jnedbal/MicroFLiC_DAC_2_2/MicroFLiC_DAC.csv

Reference | Quantity | Value | Footprint | Datasheet | Part Number | Manufacturer | Package | Supplier | Order Code | Alt. Supplier | Alt. Order Code | Note
C12 C30 C36 C38 C44 C45 C46 C49 C50 C61 C62 C73 C78 | 13 | 22u/25V | Capacitors_SMD:C_1210 |  | GRM32ER61E226ME15L | Murata | 1210 | Farnell | 1735539 | Mouser | 81-GRM32ER61E226ME5L | 22μF/25V X5R 1210 ceramic capacitor
C14 C22 C33 C41 | 4 | 10p | Capacitors_SMD:C_0603 |  | CC0603JRNPO9BN100 | Yageo | 0603 | Farnell | 721967 | Mouser | 603-C0603JRNPO9BN100 | 10pF/50V C0G(NP0) 0603 ceramic capacitor
C15 C20 C23 C28 C60 C72 | 6 | 10u/35V | Capacitors_SMD:C_1210 |  | GRM32ER6YA106KA12L | Murata | 1210 | Farnell | 1845763 | Mouser | 81-GRM32ER6YA106KA2L | 10μF/35V X5R 1210 ceramic capacitor
C10 C11 C16 C19 C2 C24 C27 C31 C35 C39 C4 C43 C63 C68 C75 C76 C77 C8 | 18 | 100n | Capacitors_SMD:C_0603 |  | CC0603KRX7R9BB104 | Yageo | 0603 | Farnell | 1362556 | Mouser | 603-CC603KRX7R9BB104 | 100nF/50V X7R 0603 ceramic capacitor
C47 C48 C69 | 3 | 1u/25V | Capacitors_SMD:C_0603 |  | GCM188R71E105KA64D | Murata | 0603 | Farnell | 2470425 | Mouser | 603-CC603KRX7R8BB105 | 1μF/25V X7R 0603 ceramic capacitor
C13 C17 C18 C21 C25 C26 C29 C32 C34 C37 C40 C42 C5 C54 C55 C56 C57 C58 C59 C6 C66 C67 C70 C71 | 24 | 10n | Capacitors_SMD:C_0603 |  | CC0603KRX7R9BB103 | Yageo | 0603 | Farnell | 722236 | Mouser | 603-CC603KRX7R9BB103 | 10nF/50V X7R 0603 ceramic capacitor
C51 C52 C53 C64 C65 C74 | 6 | 10u/25V | Capacitors_SMD:C_0805 |  | GRM219R61E106KA12D | Murata | 0805 | Farnell | 2426961 | Mouser | 603-CC805KKX5R8BB106 | 10μF/25V X5R 0805 ceramic capacitor
C1 C3 C7 C9 | 4 | 4u7/25V | Capacitors_Tantalum_SMD:TantalC_SizeB_EIA-3528_Reflow |  | TR3B475K025C0700 | Vishay | case B | Farnell | 2353145 | Mouser | 74-TR3B475K025C0700 | 4.7μF/25V/0.7Ω ESR case B tantalum capacitor
JP1 | 1 | UNI_A | jakub:solder_jumper
JP2 | 1 | UNI_B | jakub:solder_jumper
JP3 | 1 | x2_0 | jakub:solder_jumper
JP4 | 1 | x2_1 | jakub:solder_jumper
JP5 | 1 | x2_2 | jakub:solder_jumper
JP6 | 1 | x2_3 | jakub:solder_jumper
JP7 | 1 | GND/GNDA | jakub:solder_jumper
P1 | 1 | 8-way Micro-MaTch | jakub:7-188275-8 |  | 7-188275-8 | TE Connectivity | Micro-MaTch SMD | Farnell | 3784733 | Mouser | 571-7-188275-8 | 8-way SMD Micro-MaTch connector
P2 | 1 | 2x4 header strip | Pin_Headers:Pin_Header_Straight_2x04 |  | M20-9980446 | Harwin | DIL-8 | Farnell | 1022233 | Mouser | 855-M20-9980446 | 2x4 header strip
P3 | 1 | 1x2 header strip | Pin_Headers:Pin_Header_Straight_1x02 |  | M20-9990245 | Harwin | SIL-2 | Farnell | 1022245 | Mouser | 855-M20-9990245 | 1x2 header strip
P4 | 1 | 1x2 socket strip | Socket_Strips:Socket_Strip_Straight_1x02 |  | ESQ-102-33-G-S | Samtec | SIL-2 | Farnell | 1927389 | Samtec | ESQ-102-33-G-S | 1x2 ESQ series elevated socket strip
P5 P6 P7 P8 | 4 | SMA | jakub:SMA |  | 73251-2200 | Molex | SMA | Farnell | 2293854 | Mouser | 538-73251-2200 | Right-angle SMA jack
R1 R13 R15 R17 R19 R2 R21 R22 R23 R24 R3 | 11 | 12k | Resistors_SMD:R_0603 |  | RC0603FR-0712KL | Yageo | 0603 | Farnell | 9238611 | Mouser | 603-RC0603FR-0712KL | 10kΩ/1% 0805 resistor
R10 R11 | 2 | 1 | Resistors_SMD:R_0805 |  | MCWR08W1R00FTL | Multicomp | 0805 | Farnell | 2447598 | Mouser | 667-ERJ-6GEYJ1R0V | 1Ω/1% 0805 resistor
R12 R18 | 2 | 165k | Resistors_SMD:R_0805 |  | MCMR08X1653FTL | Multicomp | 0805 | Farnell | 2073657 | Mouser | 667-ERJ-6ENF1653V | 165kΩ/1% 0805 resistor
R14 R16 R20 | 3 | 48k7 | Resistors_SMD:R_0805 |  | MC01W0805148K7 | Multicomp | 0805 | Farnell | 2141883 | Mouser | 667-ERJ-6ENF4872V | 48.7kΩ/1% 0805 resistor
R25 | 1 | 150 | Resistors_SMD:R_0805 |  | MCWR08X1500FTL | Multicomp | 0805 | Farnell | 2447574 | Mouser | 71-TNPW0805150RFEEA | 150Ω/1% 0805 resistor
R4 R5 R6 R7 | 4 | 1k/0.01%/100mW | Resistors_SMD:R_0805 |  | MCTF0805TTX1001 | Multicomp | 0805 | Farnell | 2112790 | Mouser | 71-PLTT0805Z1001QGT5 | 1kΩ/0.01% 0805 resistor
R8 R9 | 2 | 49R9/0.1%/250mW | Resistors_SMD:R_0805 |  | RP73PF2A49R9BTDF | TE Connectivity | 0805 | Farnell | 2117023 | Mouser | 279-RP73PF2A49R9BTDF | 49.9Ω/0.1%/250mW 0805 resistor
RP1 | 1 | 4x150 | Resistors_SMD:R_Array_Convex_4x0603 |  | YC164-JR-07150RL | Yageo | 4×0603 | Farnell | 9234462 | Mouser | 603-YC164-JR-07150RL | 4×150Ω/5% 0603 resistor array
S1 S2 | 2 | shield_can | jakub:can-MS257-10 |  | MS257-10 | Masach | Can | RS Components | 826-6766 | Masach | MS257-10 | Two-piece EMI shielding can
U1 | 1 | DAC8734 | Housings_QFP:TQFP-48_7x7mm_Pitch0.5mm |  | DAC8734SPFB | Texas Instruments | TQFP-48 | Farnell | 2082437 | Mouser | 595-DAC8734SPFB | Quad 16-bit DAC
U11 | 1 | LM3480 | TO_SOT_Packages_SMD:SOT-23 |  | LM3480IM3-5.0 | Texas Instruments | SOT-23 | Farnell | 3160634 | Mouser | 926-LM3480IM3-50 | 100-mA SOT-23 quasi low-dropout linear voltage regulator
U12 U13 | 2 | TPS7A3001 | jakub:SSOP8_powerPAD |  | TPS7A3001DGNT | Texas Instruments | MSOP-8 | Farnell | 1855138 | Mouser | 595-TPS7A3001DGNT | Ultralow-noise negative linear regulator
U14 | 1 | LM3880 | Housings_SOT-23_SOT-143_TSOT-6:SOT-23-6 |  | LM3880MF-1AB | Texas Instruments | SOT-23-6 | Farnell | 1271399 | Mouser | 926-LM3880MF1ABNOPB | 3-output power sequencer
U15 | 1 | 74AHC1G14 | Housings_SOT-23_SOT-143_TSOT-6:SOT-23-5 |  | SN74AHC1G14DBVR | Texas Instruments | SOT-23-5 | Farnell | 1105919 | Mouser | 595-SN74AHC1G14DBVR | Single Schmitt trigger inverter
U16 | 1 | Si8651 | Housings_SOIC:SOIC-16_3.9x9.9mm_Pitch1.27mm |  | SI8651EC-B-IS1 | Silicon Labs | SOIC-16 | Farnell | 2423323 | Mouser | 634-SI8651EC-B-IS1 | Digital isolators 5 channel 3.75kV 8ns 4/1
U2 U3 | 2 | OPA211 | Housings_SSOP:MSOP-8_3x3mm_Pitch0.65mm |  | OPA211AIDGKT | Texas Instruments | MSOP-8 | Farnell | 2323341 | Mouser | 595-OPA211AIDGKT | 1.1-nV/√Hz noise low power precision operational amplifier
U4 U5 | 2 | AD8021 | Housings_SOIC:SOIC-8_3.9x4.9mm_Pitch1.27mm |  | AD8021ARZ | Analog Devices | SOIC-8 | Farnell | 9426000 | Mouser | 584-AD8021ARZ | Low noise high speed amplifier for 16-bit systems
U6 | 1 | REF5040 | Housings_SSOP:MSOP-8_3x3mm_Pitch0.65mm |  | REF5040AIDGKT | Texas Instruments | MSOP-8 | Farnell | 2323788 | Mouser | 595-REF5040AIDGKT | 5.000V low-noise very low drift precision voltage reference
U7 | 1 | REF5050 | Housings_SSOP:MSOP-8_3x3mm_Pitch0.65mm |  | REF5050AIDGKT | Texas Instruments | MSOP-8 | Farnell | 2323802 | Mouser | 595-REF5050AIDGKT | 4.096V low-noise very low drift precision voltage reference
U10 U8 U9 | 3 | TPS7A4901 | jakub:SSOP8_powerPAD |  | TPS7A4901DGNT | Texas Instruments | MSOP-8 | Farnell | 1841881 | Mouser | 595-TPS7A4901DGNT | Ultralow-noise positive linear regulator
