jnedbal/MicroFLiC_DAC_2_2/(commit log)

2016-01-06 Final production board v1.0
    [MicroFLiC_DAC_1_0-B.Cu.gbl, MicroFLiC_DAC_1_0-B.Mask.gbs, MicroFLiC_DAC_1_0-B.SilkS.gbo, MicroFLiC_DAC_1_0-Edge.Cuts.gm1, MicroFLiC_DAC_1_0-F.Cu.gtl, MicroFLiC_DAC_1_0-F.Mask.gts, MicroFLiC_DAC_1_0-F.SilkS.gto, MicroFLiC_DAC_1_0.drl]
2016-02-04 Updated part names
    [MicroFLiC_DAC_1_0.csv, highCurrentAmp_1_0.sch, highVoltageAmp_1_0.sch, powerSupply_1_0.sch]
2016-02-05 Initial commit of v1.1
    [MicroFLiC_DAC_1_0.gbl, MicroFLiC_DAC_1_0.gbo, MicroFLiC_DAC_1_0.gbs, MicroFLiC_DAC_1_0.gtl, MicroFLiC_DAC_1_0.gto, MicroFLiC_DAC_1_0.gts, MicroFLiC_DAC_1_1-B.Cu.gbl, MicroFLiC_DAC_1_1-B.Mask.gbs]
2016-02-11 Changed filenames to exclude version number
    [MicroFLiC_DAC.csv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]
2016-02-11 Updated all part descriptions
    [MicroFLiC_DAC.csv, MicroFLiC_DAC.kicad_pcb, MicroFLiC_DAC.sch, digitalIsolation.sch, highCurrentAmp.sch, highVoltageAmp.sch, powerSupply.sch, reference.sch]
2016-02-19 Fixed P8 socket Farnell code
    [MicroFLiC_DAC.sch]
2016-02-19 Fixed P2 socket Farnell code
    [MicroFLiC_DAC.kicad_pcb, MicroFLiC_DAC.sch]
2016-02-21 Fixed SO-8 to SOIC-8
    [MicroFLiC_DAC.csv, MicroFLiC_DAC.kicad_pcb, highCurrentAmp.sch]
2016-02-26 Fixed connector descriptions
    [MicroFLiC_DAC.csv, MicroFLiC_DAC.kicad_pcb, MicroFLiC_DAC.sch]
2016-03-03 Fixed LM3880 pull-up resistors to 5V
    [MicroFLiC_DAC.csv, MicroFLiC_DAC.kicad_pcb, digitalIsolation.sch, powerSupply.sch]
2016-03-10 Fixed ground problems, added bypass capacitors, added resistor between digital isolator and DAC
    [MicroFLiC_DAC.csv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]
2016-03-10 Fixed SMA connector labels and 4u7/25V capacitor order code
    [MicroFLiC_DAC.csv, MicroFLiC_DAC.kicad_pcb, MicroFLiC_DAC.sch, powerSupply.sch]
2016-03-10 Tidies up the ground further
    [MicroFLiC_DAC-B.Cu.gbl, MicroFLiC_DAC-B.Mask.gbs, MicroFLiC_DAC-B.SilkS.gbo, MicroFLiC_DAC-Edge.Cuts.gm1, MicroFLiC_DAC-F.Cu.gtl, MicroFLiC_DAC-F.Mask.gts, MicroFLiC_DAC-F.SilkS.gto, MicroFLiC_DAC.drl]
2016-03-10 Made thicker lines for SPI
    [MicroFLiC_DAC.kicad_pcb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]
2016-03-11 Tidied up ground routing
    [MicroFLiC_DAC.kicad_pcb]
2016-03-11 Expanded the board for better grounding. OP-AMPs close to connectors
    [MicroFLiC_DAC.kicad_pcb, MicroFLiC_DAC.sch, digitalIsolation.sch, powerSupply.sch]
2016-03-22 Extended board
    [MicroFLiC_DAC.kicad_pcb, MicroFLiC_DAC.sch, digitalIsolation.sch]
2016-03-22 Fixed can, 1Ohm resistor descriptions
    [MicroFLiC_DAC.csv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]
2016-03-23 Finalized PCB for production
    [MicroFLiC_DAC.csv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]
2016-03-23 Re-referenced components
    [MicroFLiC_DAC.csv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]
2016-03-23 Fixed references in Seeed BOM
    [MicroFLiC_DAC_Seeed.csv]
2016-08-05 Updated silkscreen to reflect version 2.2
    [MicroFLiC_DAC.kicad_pcb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]
